joeymariano/bend-platform-v2/docs/bend-locations/bend-studying.jpg

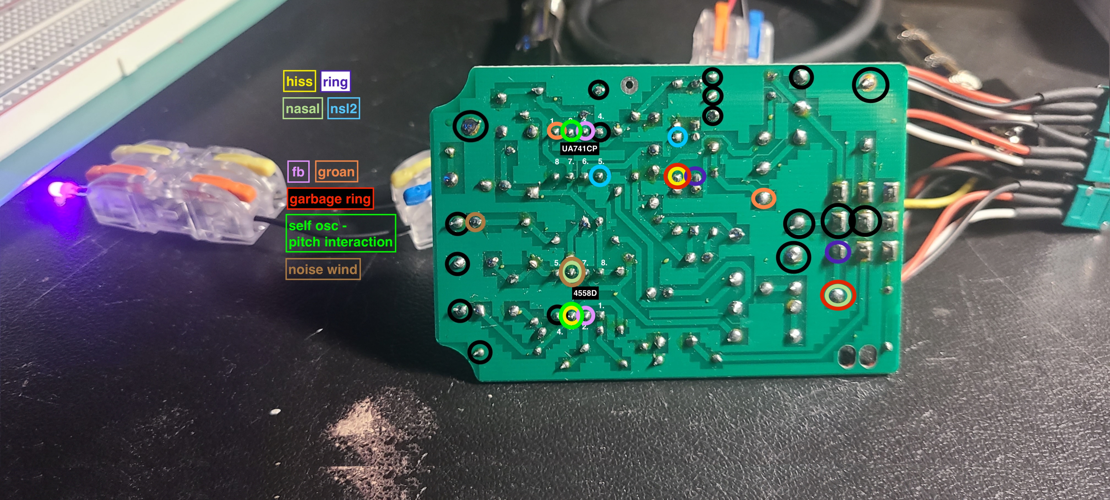
docs/bend-locations/bend-studying.jpg
