joeymariano/bend-platform-v2/docs/bend-locations/final-bends.jpeg

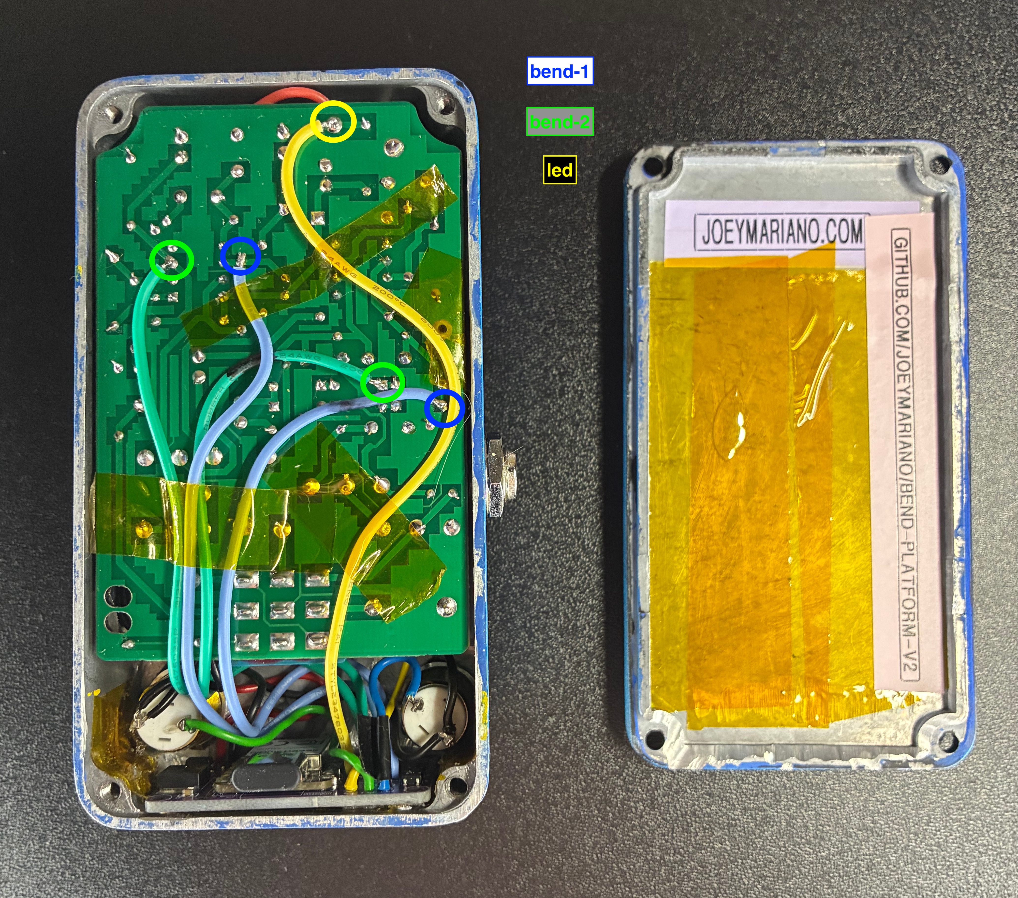
docs/bend-locations/final-bends.jpeg
