joeymariano/bend-platform-v2/docs/final-mod+wiring/back.jpeg

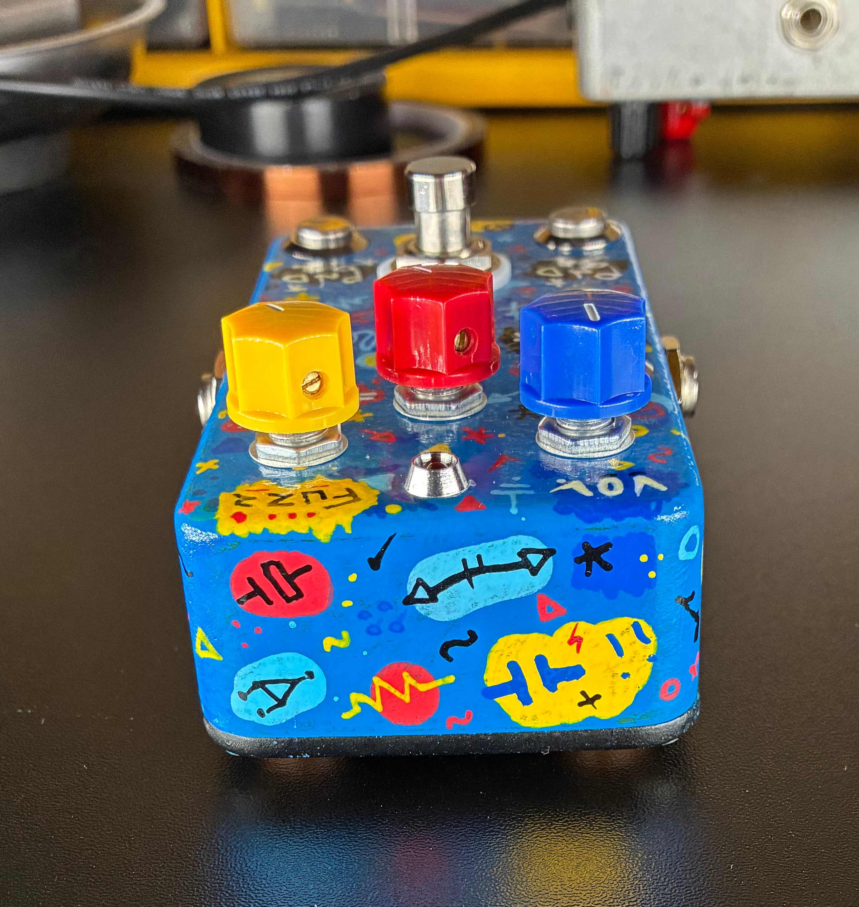
docs/final-mod+wiring/back.jpeg
