joeymariano/bend-platform-v2/docs/final-mod+wiring/bottom.jpeg

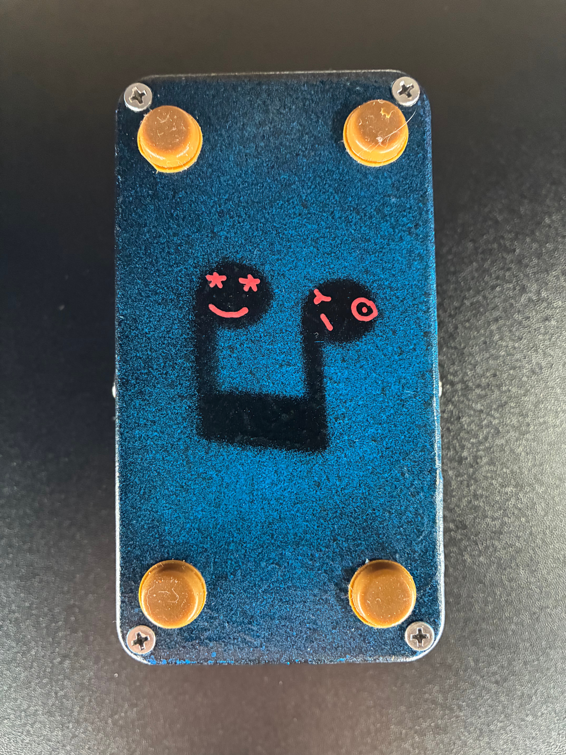
docs/final-mod+wiring/bottom.jpeg
