joeymariano/bend-platform-v2/docs/final-mod+wiring/side-ac.jpeg

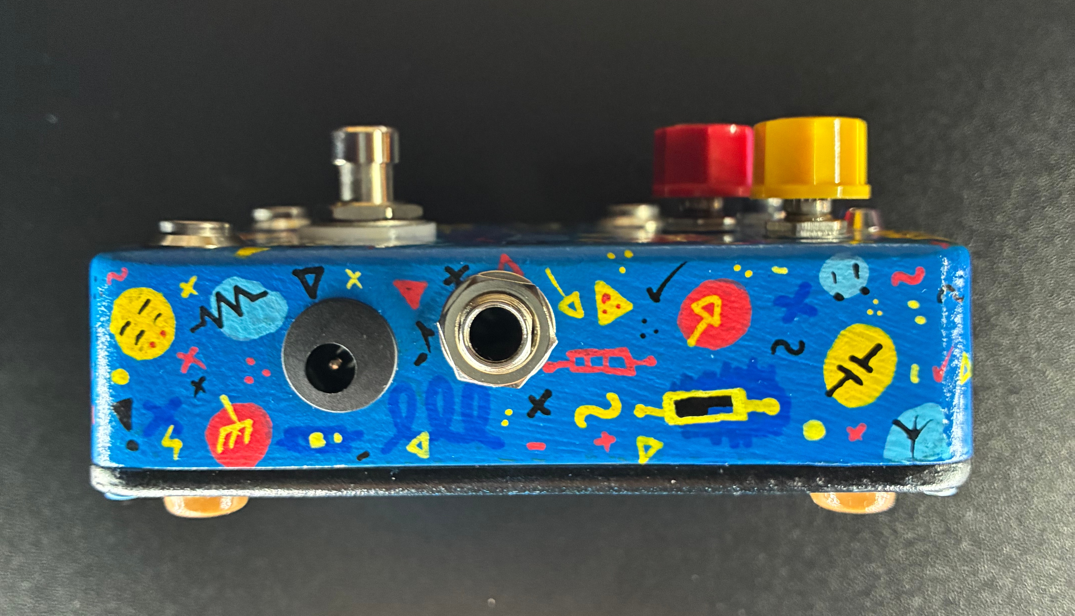
docs/final-mod+wiring/side-ac.jpeg
