joeymariano/bend-platform-v2/docs/final-mod+wiring/side.jpeg

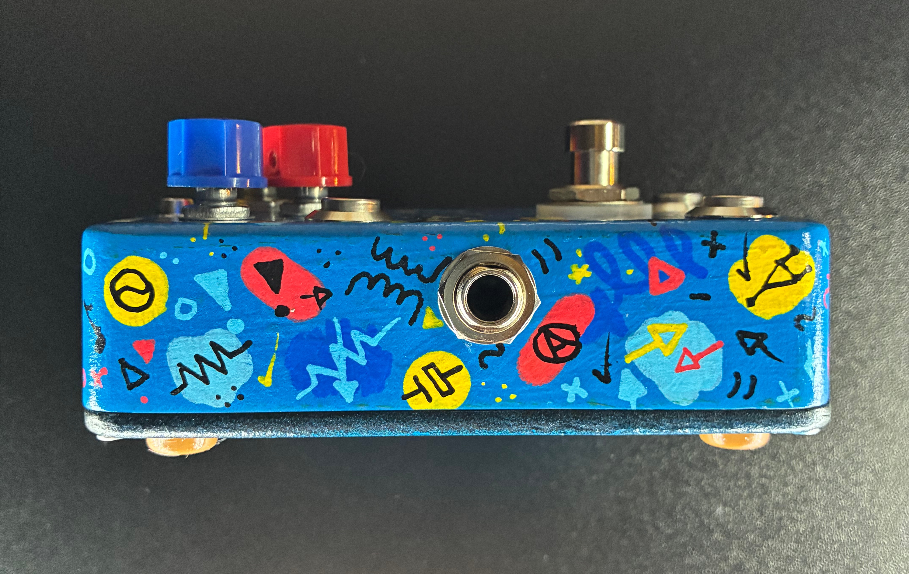
docs/final-mod+wiring/side.jpeg
