joeymariano/bend-platform-v2/docs/final-mod+wiring/top.jpeg

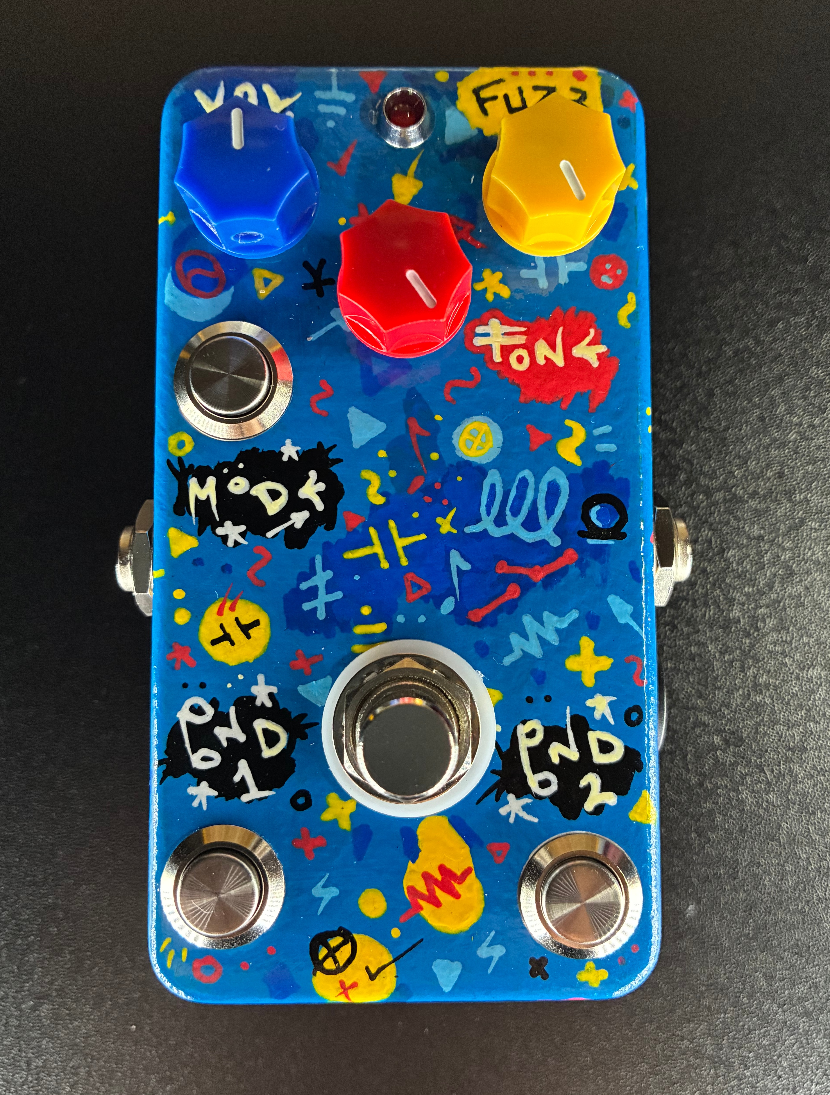
docs/final-mod+wiring/top.jpeg
