joeymariano/bend-platform-v2/speed.ino

// =====================================================================================
//  speed.ino  -  speed mode: set how fast the stutter / sequencer (and LED pulse) runs
// =====================================================================================
//
//  Long-press MODE to enter (from mode 2, 4 or 5 only) or leave (mode.ino). The LED
//  ramps up twice going in, down twice coming out. In speed mode:
//    - the bends keep running, at the new speed; presses don't toggle a latch (bends.ino)
//    - the LED pulses at the current speed, as a guide (led.ino)
//    - BTN-1 slows it down, BTN-2 speeds it up (each acts on release)
//    - after SPEED_TIMEOUT_MS with no button pressed or held, it leaves on its own,
//      exactly like a long press
//
//  The speed multiplies the trem modes' rates and the sequencer's, so they change
//  together. It's saved to flash on leaving speed mode, and loaded at power-up
//  (flash.ino).
//
// =====================================================================================

unsigned long speedActiveAt = 0;   // millis() of the last button activity in speed mode

// -------------------------------------------------------------------------------------
//  setSpeedSteps(n)  -  the only place that sets the speed
// -------------------------------------------------------------------------------------
void setSpeedSteps(int n) {
  speedSteps = constrain(n, -SPEED_MAX_STEPS, SPEED_MAX_STEPS);
  clockSpeed = powf(SPEED_STEP, speedSteps);
}

// -------------------------------------------------------------------------------------
//  toggleSpeedMode()  -  enter or leave speed mode
// -------------------------------------------------------------------------------------
//  Leaving saves the speed first, so the flash write doesn't stall the LED sweep.
//  Only entering restarts the clock: leaving (maybe by timeout, mid-song) keeps the
//  stutter's rhythm.
// -------------------------------------------------------------------------------------
void toggleSpeedMode() {
  speedMode = !speedMode;
  if (speedMode) {
    clockStart = millis();       // the pulse starts fresh
    speedActiveAt = millis();   // the timeout starts now
  } else {
    saveIfChanged();            // flash.ino
  }
  startSweep(speedMode);  // ramps up entering, down leaving (led.ino)

#if LOG
  Serial.print(speedMode ? "SPEED mode ON, " : "SPEED mode OFF, ");
  Serial.print(clockSpeed, 2); Serial.println("x");
#endif
}

// -------------------------------------------------------------------------------------
//  speedButton(idx, edge)  -  a bend button in speed mode (called by serviceBends)
// -------------------------------------------------------------------------------------
//  On release: BTN-1 (idx 0) one step slower, BTN-2 (idx 1) one step faster.
// -------------------------------------------------------------------------------------
void speedButton(int idx, ButtonEdge edge) {
  if (edge != BTN_RELEASE) return;

  int dir = (idx == 0) ? -1 : +1;
  setSpeedSteps(speedSteps + dir);
  clockStart = millis();   // restart the pulse, so the new speed shows at once

#if LOG
  Serial.print("BTN-"); Serial.print(idx + 1);
  Serial.print(dir < 0 ? " -> slower, " : " -> faster, ");
  Serial.print(clockSpeed, 2); Serial.println("x");
#endif
}

// -------------------------------------------------------------------------------------
//  serviceSpeedTimeout()  -  called once per loop: leave speed mode when left idle
// -------------------------------------------------------------------------------------
//  Any button pressed, released or held counts as activity, so holding a bend in
//  mode 2 doesn't time out.
// -------------------------------------------------------------------------------------
void serviceSpeedTimeout() {
  if (!speedMode) return;

  bool active = modeBtn.down || modeBtn.edge != BTN_NONE;
  for (int i = 0; i < NUM_BENDS; i++) {
    if (bends[i].button.down || bends[i].button.edge != BTN_NONE) active = true;
  }

  if (active) {
    speedActiveAt = millis();
  } else if (millis() - speedActiveAt >= SPEED_TIMEOUT_MS) {   // wrap-safe
#if LOG
    Serial.println("SPEED mode timed out");
#endif
    toggleSpeedMode();
  }
}
