joeymariano/bend-platform-v2/(commit log)

2026-10-28 Fix pedal LED rest polarity and speed up mode blink
    The LED now rests LOW (on, following the 3PDT) and each mode blink
    pulses HIGH (dark), to match Q1 shunting the LED anode. Polarity lives
    in LED_IDLE / LED_PULSE. Blink pulse and gap cut from 500 ms to 223 ms.
2026-10-28 Split sketch into commented tabs and fix LED wiring docs
    Break bend-platform-v2.ino into tabs: config.h (pins, polarity, timings,
    flags, types, wiring diagram), buttons.ino, bends.ino, mode.ino, led.ino.
    Add a Mode enum, named pins, and NUM_BENDS loops, and rename
    PEDAL_LED -> MAIN_LED and BLINK_DARK_MS -> BLINK_PULSE_MS. Behavior is
    unchanged.
    Docs now describe physical buttons on a circuit-bent device, and the Q1
    LED hack as one wire (LED- pad -> device LED+, GND pad unused).
2026-10-28 Add mode-aware main LED animation with ultrasonic PWM
    Drive D1 from TCC0 at ~23 kHz (above hearing) so the main LED can be
    dimmed without whining into the audio. setLedBrightness() is now the
    only LED writer, gamma-corrected.
    The LED rests dim, goes full while a bend is engaged (momentary and
    latching), and in the trem modes pulses with a raised-cosine bump, 25%
    of each stutter cycle wide. Mode blinks still take priority.
    Both bends now share one stutter clock (tremStart), so they flip
    together and the LED pulse lines up with the bend cutting in. Levels,
    pulse width, gamma and PWM top are tunable in config.h.
2026-10-29 Tighten sketch comments and fix ones that contradicted the code
    Comments only; code is unchanged. Fixed comments that disagreed with
    the code: bend gate polarity, blink vs animation priority, who reads
    anyStuttering, how the mode blink ends, and the LOG build claim.
2026-10-29 Refactor bends, mode checks, and LED state for readability
    - logMode() replaces the duplicated mode log line
    - isTremMode() / isLatchingMode() hold the mode rules in one place
    - serviceBend() decides "wanted" and "stutter" instead of a 4-way switch
    - setSwitch() only writes the gate; each Bend records on / stuttering,
    and serviceBends() builds anyEngaged / anyStuttering from them
    - tremolo() becomes tremPhaseOn(), which only reads the shared clock
    - blink state moves into led.ino, its only user
2026-10-29 Remove v1 board support and docs
    - config.h: drop BOARD_V2 and the v1 polarity; bends are always
    active-LOW (BEND_ON = LOW, BEND_OFF = HIGH)
    - Serial.begin() only runs when LOG is on
    - README, hardware notes and kit notes describe the v2 board only;
    repo contents list matches the reorganized docs folders
2026-10-30 Add hardware watchdog that resets the board if the sketch hangs
    watchdog.ino enables the SAMD21 WDT (about 2 s, WDT_TIMEOUT in config.h) at the end
    of setup(); loop() feeds it every pass. A watchdog reset is logged at boot. Docs
    updated; trimmed two banner comments in the main tab.
2026-10-30 Add speed mode with flash-saved speed, release-based buttons, clearer names
    - Speed mode: long-press MODE (on release) to enter/leave; LED fast-flashes, then
    pulses at the stutter speed. BTN-1/BTN-2 (on release) step it 10% slower/faster,
    0.26x-3.8x, scaling both trem modes. Bends stay off while in it.
    - flash.ino: saves a Settings record (magic + check word) to the last flash row with
    raw NVMCTRL commands, no library. The speed is saved on leaving speed mode if it
    changed, and loaded at power-up.
    - Buttons: bends still fire on contact in modes 1-4; every other action (MODE short
    and long press, speed buttons) acts on release. readButton() reports press and
    release; pressLength()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
2026-10-30 Toggle speed mode at the 2 s mark of a MODE hold, not on release
    LONG_PRESS_MS is now 2000. The long press fires as soon as the hold reaches it;
    the release that follows does nothing. Short presses still act on release.
    pressLength() now also works while the button is held.
2026-11-02 Save the bend mode, keep bends running in speed mode, fix gate-resistor note
    - Mode is saved to flash with the speed, 3 s after the last short MODE press
    (MODE_SAVE_MS), so tapping through modes writes once. Loading and saving now
    live in flash.ino; SETTINGS_VERSION bumped to 2.
    - Speed mode: the bends keep running so the new speed is heard at once; presses
    set the speed and don't toggle a latch.
    - Speed mode can be entered only from the trem modes (2, 4); leaving always works.
    - HARDWARE-V2-NOTES: the boot glitch is audible. Fix is a pull-up to 3V3 on the
    Q2/Q3 gates and a pull-down on Q1, not gate-to-source on Q2/Q3 (that holds the
    bends on).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
2026-11-02 Read all buttons first, then decide, then drive bends and LED
    loop() now runs in five stages: readButtons() samples every button once,
    serviceMode() handles mode/speed logic, then the bends, then the LED, then
    housekeeping. A MODE change now reaches the bends on the same pass.
2026-11-02 crop mod pick and add schematic to Readme
2026-11-02 Shrink README images, put schematic and pedal photo side by side
2026-11-02 Code review fixes: ~2 ms button response, interval guard, clock names
    - readButton() acts once a change holds for BTN_CONFIRM_MS (2 ms), then locks
    the button out for DEBOUNCE_MS. Presses and releases used to land 50 ms late.
    - clockInterval() never returns 0, and config.h refuses clock timings under 4 ms,
    so user-tuned values can't divide by zero.
    - The shared clock is used by the sequencer too, so trem*/stuttering names
    become clock*/clocked. No behavior change.
2026-11-02 README: schematic and pedal photo fill one row at equal height
2026-11-02 README: footswitches, patch bay jacks and cable length notes
